BlockWorker/EE-BluetoothSpeaker/(list of files, drawings)

Other design files:
4kHz crossover + preamp.ms14
Amplitude follower.ms14
