BlockWorker/EE-BluetoothSpeaker/BlockBox.brd

## EAGLE design BlockBox.brd (continued)

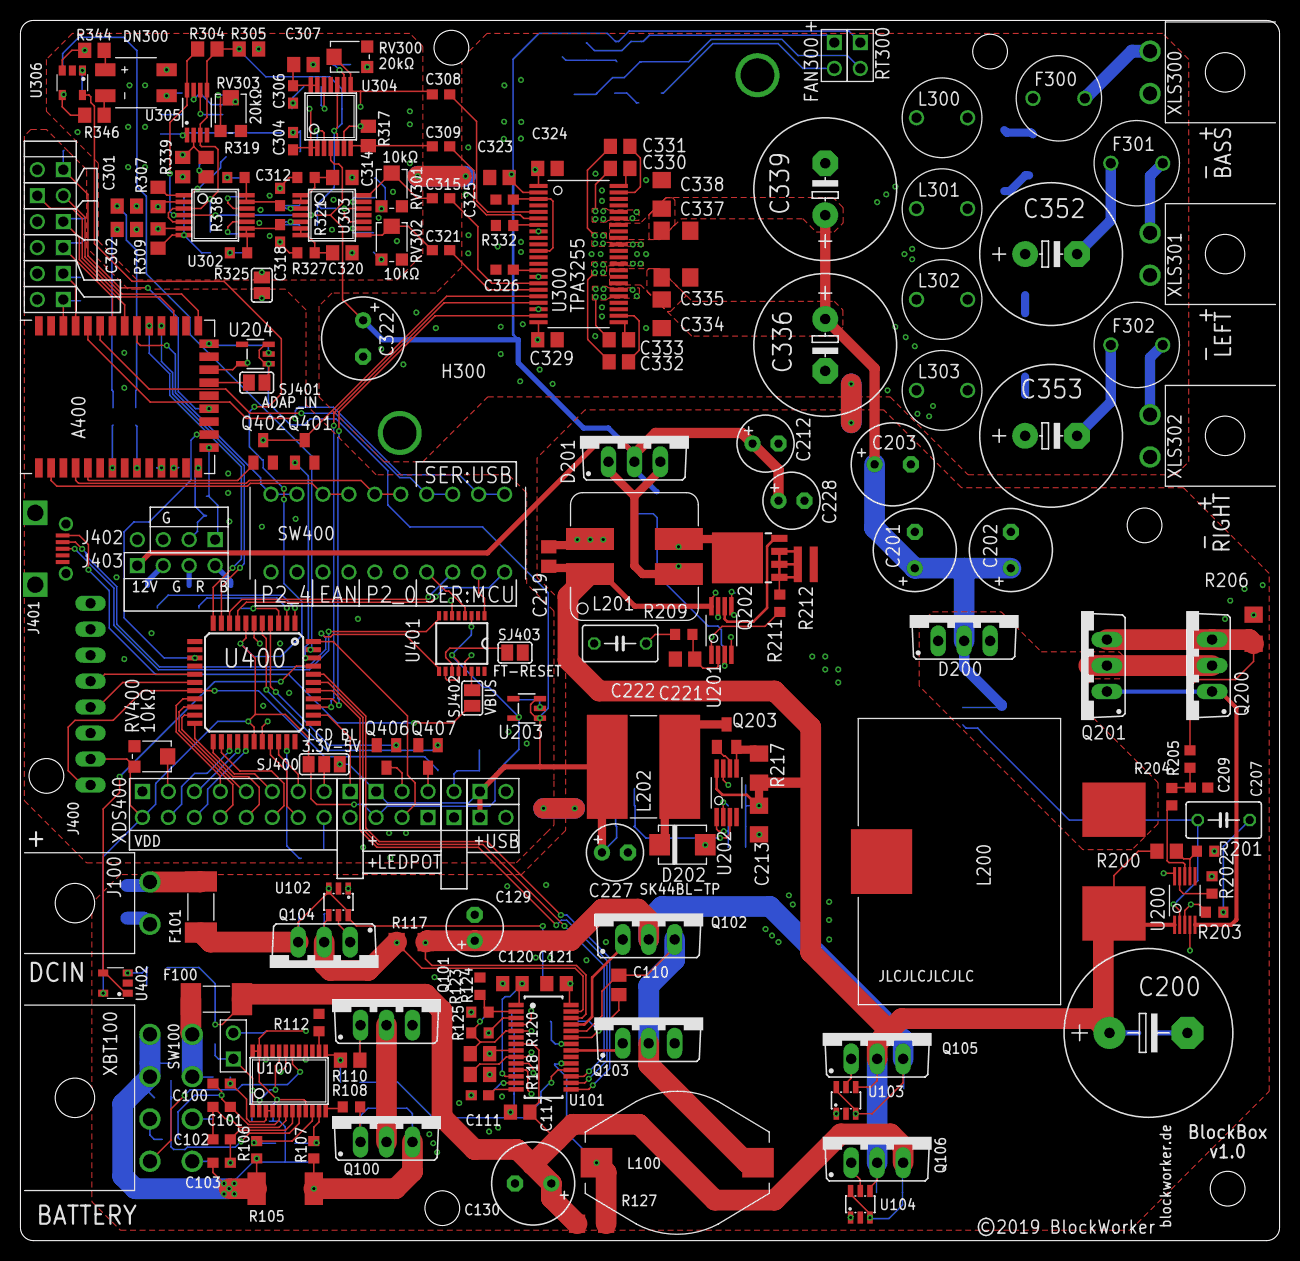
[picture p6: board BlockBox.brd from above]

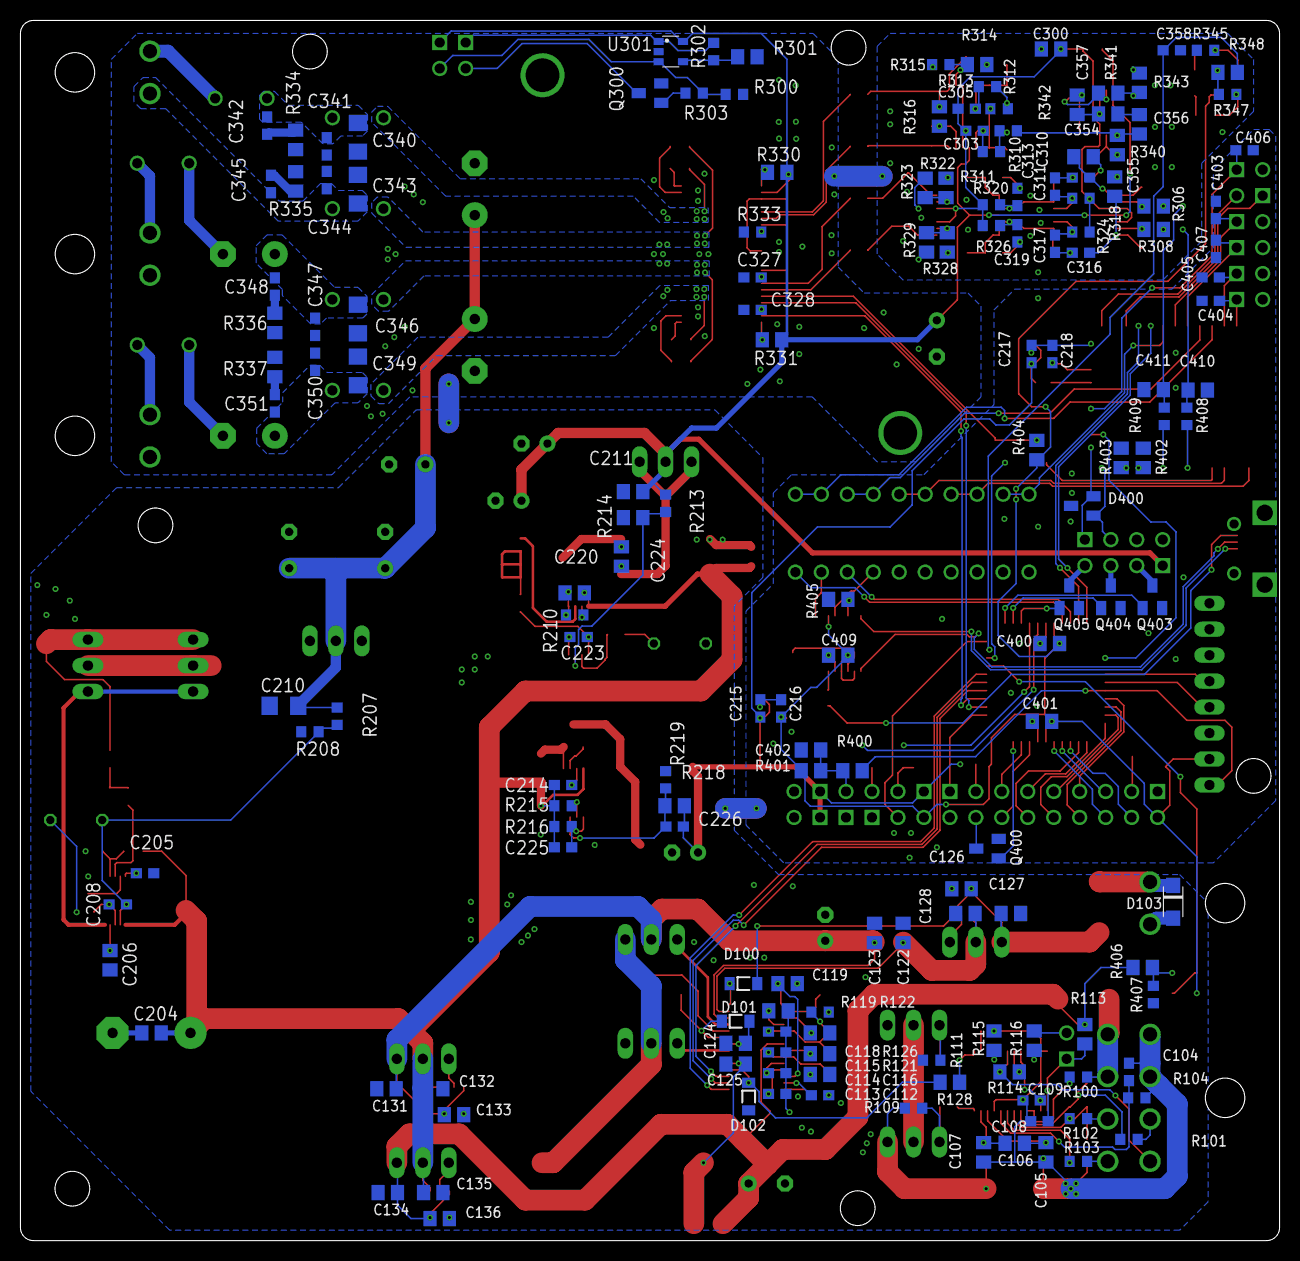
[picture p7: board BlockBox.brd from below]

Board: 2 copper layers, 123.2 x 119.4 mm, 344 parts (162 on the bottom side), 260 nets.
