BlockWorker/EE-BluetoothSpeaker/ButtonBoard.brd

## EAGLE design ButtonBoard.brd (2019-08-19)

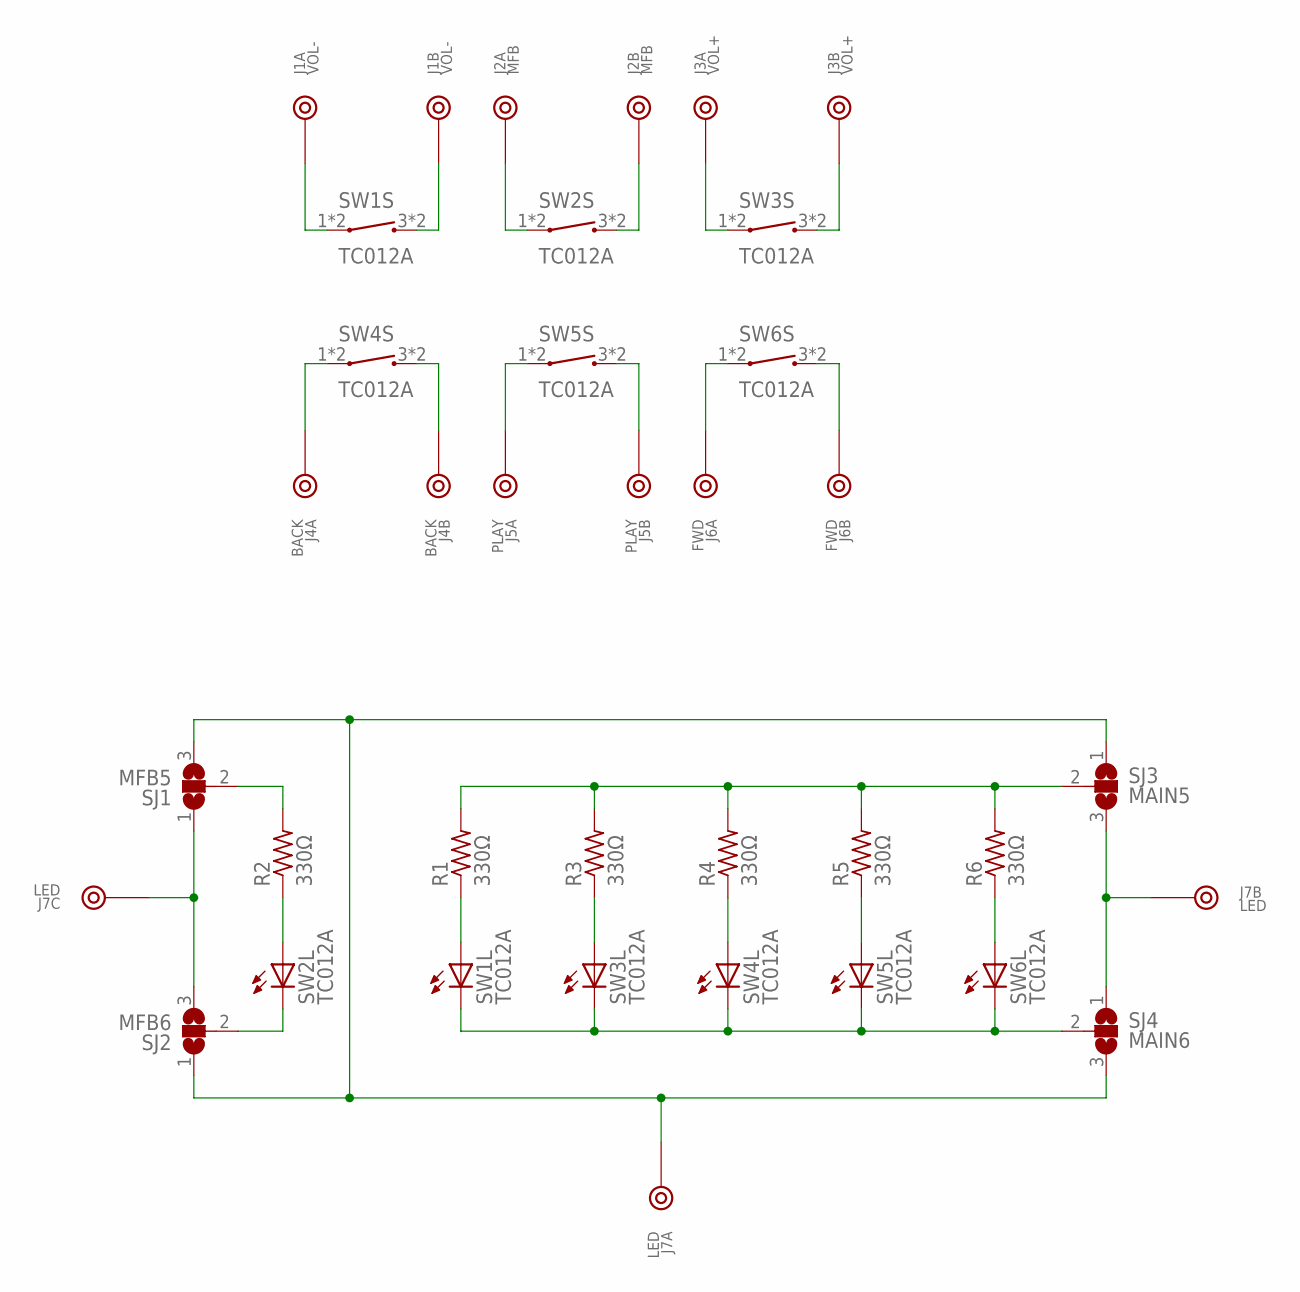
[picture p8: schematic ButtonBoard.sch]

Parts:
J1: VOL-; 2PIN
J2: MFB; 2PIN
J3: VOL+; 2PIN
J4: BACK; 2PIN
J5: PLAY; 2PIN
J6: FWD; 2PIN
J7: LED; 3PIN
R1, R2, R3, R4, R5, R6: 330Ω; R0805
SJ1: MFB5; SJ_2
SJ2: MFB6; SJ_2
SJ3: MAIN5; SJ_2
SJ4: MAIN6; SJ_2
SW1, SW2, SW3, SW4, SW5, SW6: TC012A

Connections:
BACK1: J4.1, SW4.1, SW4.2 (1)
BACK2: J4.2, SW4.3 (2), SW4.4 (2)
FWD1: J6.1, SW6.1, SW6.2 (1)
FWD2: J6.2, SW6.3 (2), SW6.4 (2)
LED_5V: J7.1, SJ1.3, SJ2.1, SJ3.1, SJ4.3
LED_BACK_5R: R4.1, SW4.5 (A)
LED_FWD_5R: R6.1, SW6.5 (A)
LED_MAIN_5: R1.2, R3.2, R4.2, R5.2, R6.2, SJ3.2
LED_MAIN_6: SJ4.2, SW1.6 (C), SW3.6 (C), SW4.6 (C), SW5.6 (C), SW6.6 (C)
LED_MAIN_GND: J7.2, SJ3.3, SJ4.1
LED_MFB_5: R2.2, SJ1.2
LED_MFB_5R: R2.1, SW2.5 (A)
LED_MFB_6: SJ2.2, SW2.6 (C)
LED_MFB_GND: J7.3, SJ1.1, SJ2.3
LED_PLAY_5R: R5.1, SW5.5 (A)
LED_VOL+_5R: R3.1, SW3.5 (A)
LED_VOL-_5R: R1.1, SW1.5 (A)
MFB1: J2.1, SW2.1, SW2.2 (1)
MFB2: J2.2, SW2.3 (2), SW2.4 (2)
PLAY1: J5.1, SW5.1, SW5.2 (1)
PLAY2: J5.2, SW5.3 (2), SW5.4 (2)
VOL+1: J3.1, SW3.1, SW3.2 (1)
VOL+2: J3.2, SW3.3 (2), SW3.4 (2)
VOL-1: J1.1, SW1.1, SW1.2 (1)
VOL-2: J1.2, SW1.3 (2), SW1.4 (2)

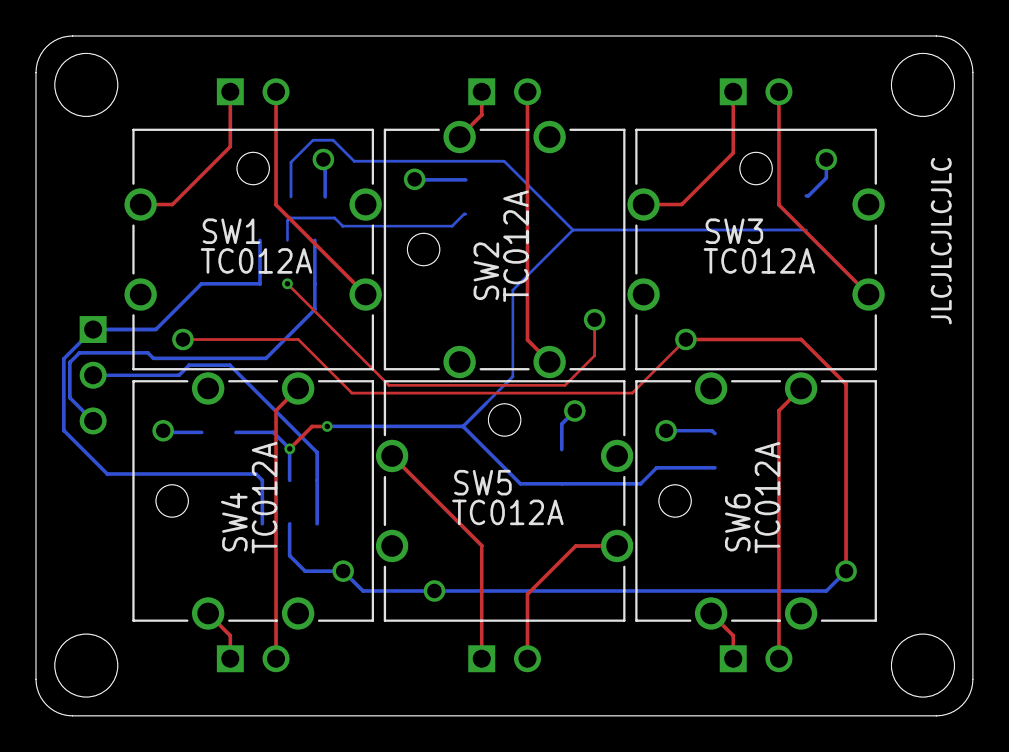
[picture p9: board ButtonBoard.brd from above]

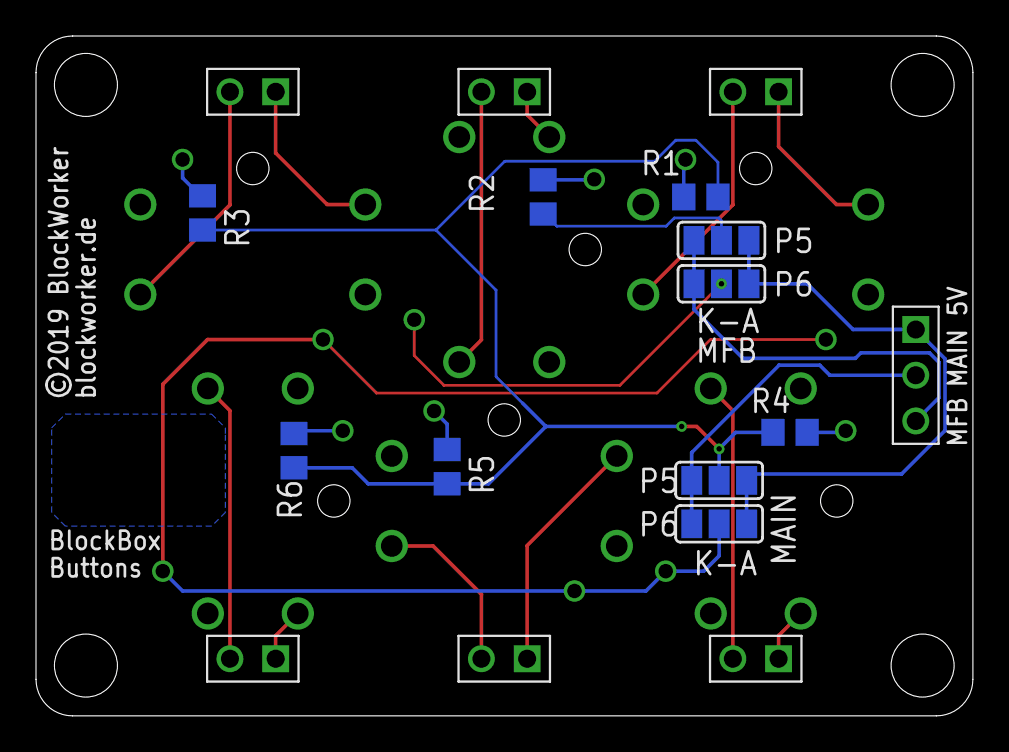
[picture p10: board ButtonBoard.brd from below]

Board: 2 copper layers, 52.0 x 37.8 mm, 23 parts (17 on the bottom side), 25 nets.
