BlockWorker/EE-BluetoothSpeaker/MCU/BlockBox.X/uart.h

/* Microchip Technology Inc. and its subsidiaries.  You may use this software 
 * and any derivatives exclusively with Microchip products. 
 * 
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
 * IN NO EVENT WILL MICROCHIP BE LIABLE FOR ANY INDIRECT, SPECIAL, PUNITIVE, 
 * INCIDENTAL OR CONSEQUENTIAL LOSS, DAMAGE, COST OR EXPENSE OF ANY KIND 
 * WHATSOEVER RELATED TO THE SOFTWARE, HOWEVER CAUSED, EVEN IF MICROCHIP HAS 
 * BEEN ADVISED OF THE POSSIBILITY OR THE DAMAGES ARE FORESEEABLE.  TO THE 
 * FULLEST EXTENT ALLOWED BY LAW, MICROCHIP'S TOTAL LIABILITY ON ALL CLAIMS 
 * IN ANY WAY RELATED TO THIS SOFTWARE WILL NOT EXCEED THE AMOUNT OF FEES, IF 
 * ANY, THAT YOU HAVE PAID DIRECTLY TO MICROCHIP FOR THIS SOFTWARE.
 *
 * MICROCHIP PROVIDES THIS SOFTWARE CONDITIONALLY UPON YOUR ACCEPTANCE OF THESE 
 * TERMS. 
 */

/* 
 * File:   
 * Author: 
 * Comments:
 * Revision history: 
 */

// This is a guard condition so that contents of this file are not included
// more than once.  
#ifndef _UART_H
#define	_UART_H

#define _XTAL_FREQ 64000000

#include <stdint.h>
#include <stdbool.h>
#include <xc.h> // include processor files - each processor file is guarded.  

#ifdef	__cplusplus
extern "C" {
#endif /* __cplusplus */
    
    uint8_t volume_level = 0;
    bool pairing = false;
    bool streaming = false;
    bool connected = false;
    bool on = false;

    void uart_init();
    void uart_tasks();
    void uart_send(uint8_t* buf, uint8_t len);

#ifdef	__cplusplus
}
#endif /* __cplusplus */

#endif	/* _UART_H */
