BlockWorker/EE-BluetoothSpeaker/(commit log)

2019-08-02 Battery management & power converters done (for now).
    [BlockBox.sch]
2019-08-03 Changed 12V converter, added audio crossover & preamp stage
    [BlockBox.sch]
2019-08-05 Audio path finished, revised 5V supply
    [BlockBox.sch]
2019-08-05 Changed bass input to summing amp (L+R), added preliminary BM62 configs.
    [BlockBox.sch]
2019-08-08 Schematic mostly done, added Multisim circuit files
    [4kHz crossover + preamp.ms14, Amplitude follower.ms14, BlockBox.sch]
2019-08-09 Finished up digital section, schematic done for now.
    [BlockBox.sch]
2019-08-19 Design initially completed.
    [BlockBox.brd, BlockBox.sch, ButtonBoard.brd, ButtonBoard.sch]
2019-08-19 Final checks and fixes applied.
    [BlockBox.brd, BlockBox.sch, ButtonBoard.brd, ButtonBoard.sch]
2019-09-29 Minor changes to UI/DSP made during build, major MCU progress.
    [4kHz crossover + preamp.ms14]
2019-10-09 More MCU work (mostly UART comms), small BM-UI changes.
2019-10-21 Changed some battery management/protection logic, made S2L more responsive (faster decay)
2020-01-08 Updates etc.
    [BlockBox.sch]
