BlockWorker/EE-BluetoothSpeaker/(notices)

Notices in the files:
BlockBox.brd:
©2019 BlockWorker
